lhr-solar/BPS-PeripheralSOMPCB/(threads)

Thread 3 (2023-09-29):

Reverse Polarity protection circuit big broke 🤯

Lakshay983, 2023-09-29:
The MOSFET on the PowerDist sheet that we use for reverse polarity protection is flipped. Specifically, the drain and the source are flipped.

With our current circuit if you plug it in backwards it won't form the body diode that we want.

Good reference for how it should be: https://electronics.stackexchange.com/questions/588808/reverse-polarity-voltage-protection-using-p-mosfet

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

Closed 2023-11-21.

Thread 4 (2023-09-30):

i forgot adc :( :( :(

Champers5000, 2023-09-30:
ADC pins need to be connected to the connector

Lakshay983, 2023-10-07:
As per Data Aq's request, we'll turn pins 4 and 2 into ADC pins
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

Lakshay983, 2023-10-13:
Nvm i lied it's pins 18 and 20

Lakshay983, 2023-10-18:
Resolved in #5

Closed 2023-10-18.

Thread 10 (2024-03-23):

PeripheralSOM v1.2 Issues

Lakshay983, 2024-03-23:
- Reset button of the STM32 is only turning things off, not on.
- The testpoint for 5V_ISO and GNDPWR looks like it is referring to the connector, could be formatted better

There are more to be added later as we test.

Lakshay983, 2024-03-24:
Maybe move the GND to the 3rd pin on the SWD connector. Make it a 1 to 1 map of the Nucleo connector

Lakshay983, 2024-03-26:
Connector pinout is hard to figure out, would be useful to add more silkscreen labels to the connector. It won't be used while it is on a daughter board but it could be useful if we're soldering wires directly or debugging.

Lakshay983, 2024-03-26:
#11 this guy is an actual circuit bug

Lakshay983, 2024-03-31:
To test things like I2C, the ADC, or SPI we need to have a soldered daughterboard with those connections broken out.

It could be useful to have test pads that break out useful connections for testing. (preferably we have as much overlap as possible between things).

Space is definitely an issue, so we should use solder pads and use the inner layers.

Lakshay983, 2024-03-31:
Show the distinction between the non-isolated GND and isolated GND on testpoints better.

IshDeshpa, 2024-03-31:
very minor thing, I think it would be good if the labels on the pins for the SWD connector was "SWDIO" and "SWCLK" so that it's clear that these pins aren't for some other purpose. Or some other indicator that it's an SWD connector on the silkscreen would be good

Closed 2025-08-14.

Thread 11 (2024-03-24):

Emitter and Base on Capacitance Multiplier chip are flipped

Lakshay983, 2024-03-24:
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
The symbol we have on the schematic has them flipped from what they should be from the datasheet(v1.2)
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

Thread 12 (2024-04-07):

Boot0 pin left floating

Lakshay983, 2024-04-07:
We left the Boot0 pin floating when it should be connected to smth. Either GND or pullup to 3.3V (we should do gnd tho).

it's the PH3 pin on the stm32l4 we use rn
