lhr-solar/BPS-PeripheralSOMPCB/CubeMX/CubeMX.ioc

Mcu.UserName=STM32L431CBTx
PA10.Signal=USART1_RX
PA9.Signal=USART1_TX
PB10.Signal=S_TIM2_CH3
PB6.Signal=I2C1_SCL
PB7.Signal=I2C1_SDA
